AidanJones/pocket_bar_billiards/previews/felt_template_A4.pdf

# Desk bar billiards - felt & marking template

Mini table | ball 9.53 mm | scale 1:5.00

playing area 160.1 x 284.1 mm

PRINT AT 100% / 'Actual size' - check the 50 mm bar on every page.

Pages are numbered row-col; tape them together on the

alignment crosses (2 rows x 1 cols).

Solid outline | = felt cut line (it butts up to the rail cushions).
Hole circles | = cut the felt at 11.4 mm.
Black dot | = black skittle. | White dots = white skittles.

Dashed circles = alternative white position (in front of the 50s).

Red dot = red-ball spot. White dot in the D = starting spot.

Mark the spots through the paper with an awl or a fine pen, then

cut the holes with a sharp craft knife.

x100 x10 x1

| 0 1 2 3 4 5 6 7 8 9

# Scoreboard scale

PRINT AT 100% / 'Actual size' - check the 50 mm bar below.

Cut out the two dashed strips and glue them to score_face:

the digit strip under the bottom row, the multiplier strip

down the left-hand edge. The grey outline is the plate and

the grey bars are the slots - they are there to line it up,

not to cut.

50 mm

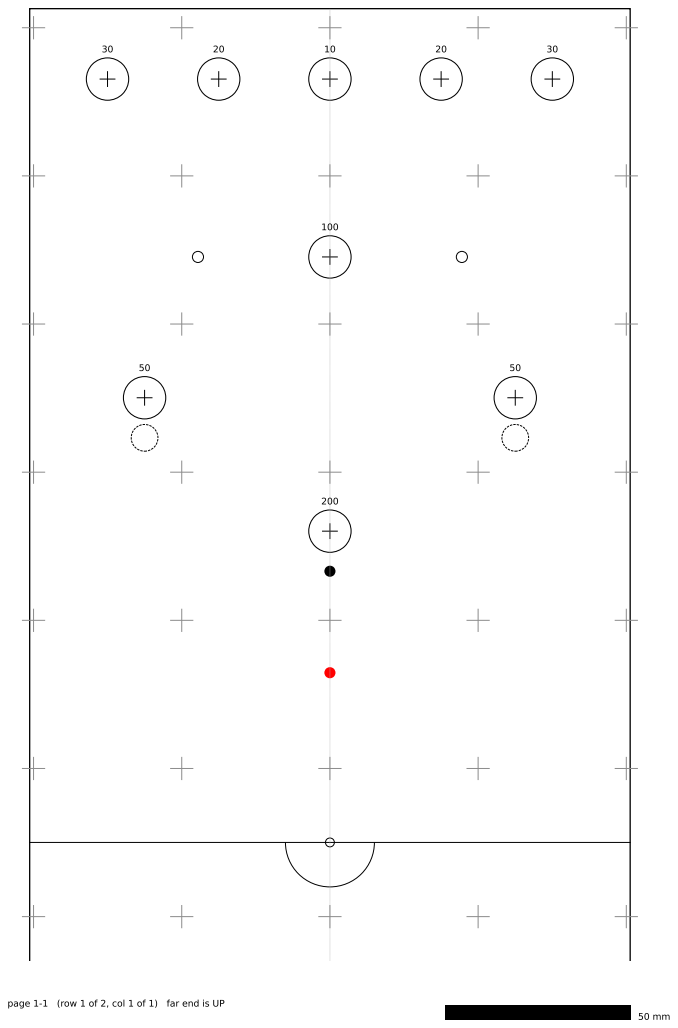
[picture p14: page 3]

page 1-1 (row 1 of 2, col 1 of 1) far end is UP

page 2-1 (row 2 of 2, col 1 of 1) far end is UP 50 mm
