AidanJones/pocket_bar_billiards/stl/score_marker.stl

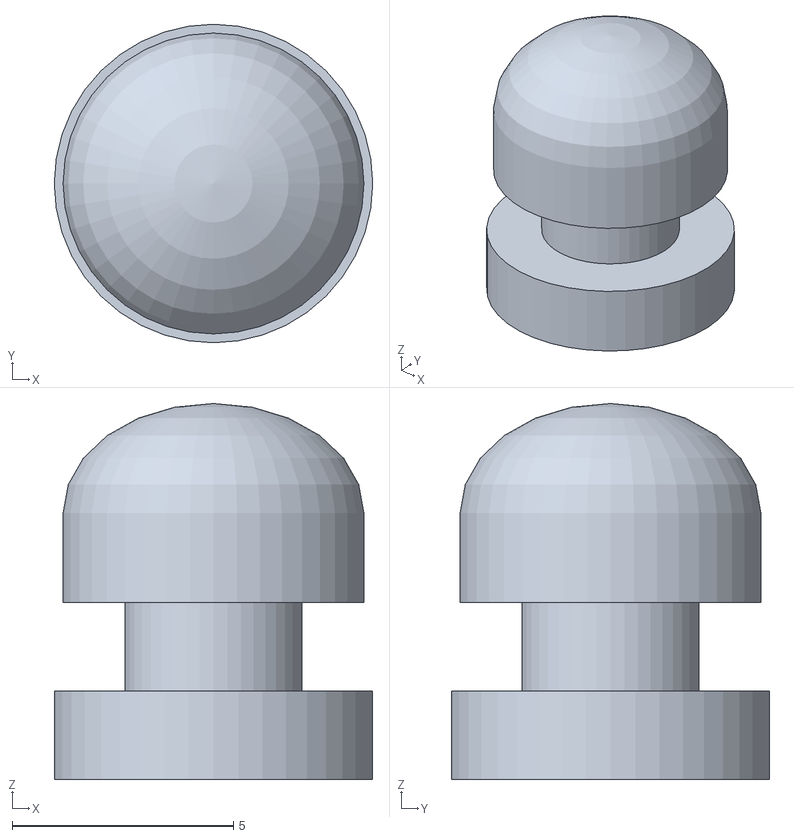
[picture p15: CAD file, 2026-11-01]
stl/score_marker.stl
7.20 x 7.20 x 8.50
