AidanJones/pocket_bar_billiards/stl_coupon/test_ramp.stl

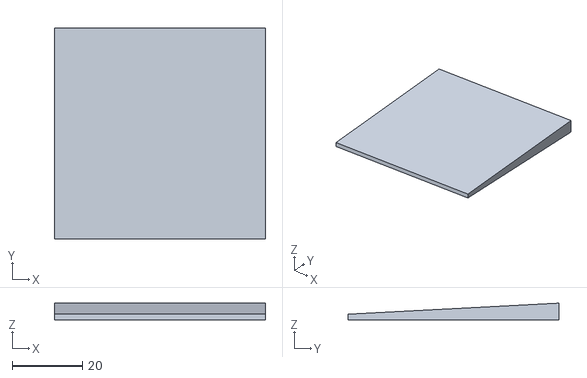
[picture p16: CAD file, 2026-11-01]
stl_coupon/test_ramp.stl
60.0 x 60.0 x 4.76
