AidanJones/pocket_bar_billiards/stl/score_track.stl

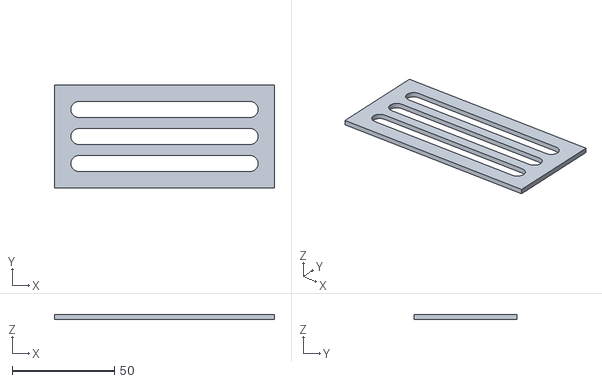
[picture p17: CAD file, 2026-11-01]
stl/score_track.stl
107.5 x 50.2 x 2.40
