AidanJones/pocket_bar_billiards/stl_coupon/test_hole_gauge.stl

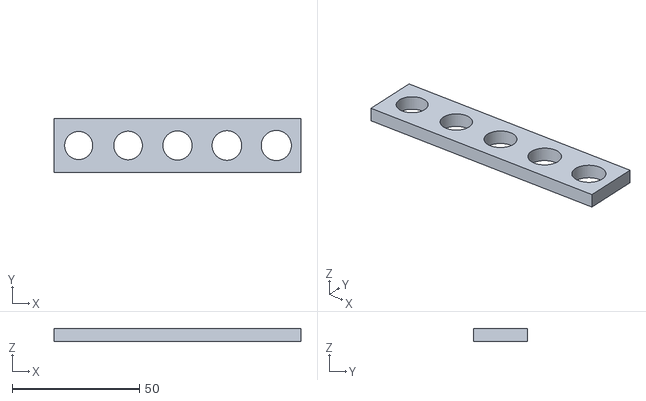
[picture p18: CAD file, 2026-11-01]
stl_coupon/test_hole_gauge.stl
97.2 x 21.4 x 5.00
