AidanJones/pocket_bar_billiards/stl/score_back.stl

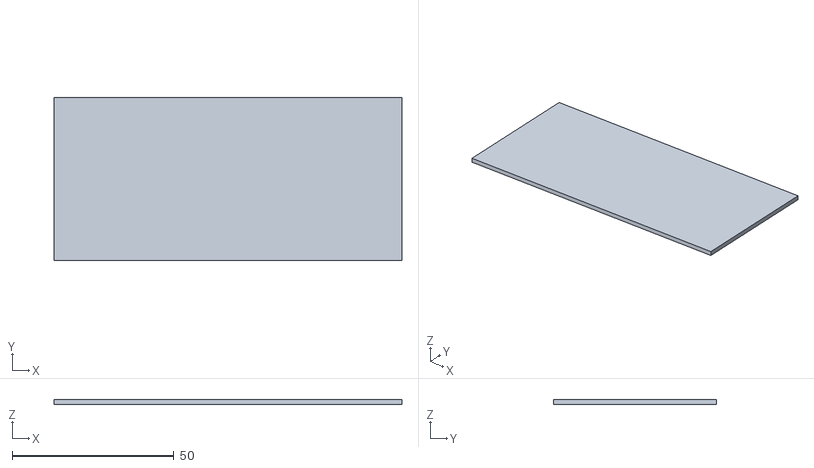
[picture p19: CAD file, 2026-11-01]
stl/score_back.stl
107.5 x 50.2 x 1.60
