AidanJones/pocket_bar_billiards/stl_coupon/test_playfield_corner.stl

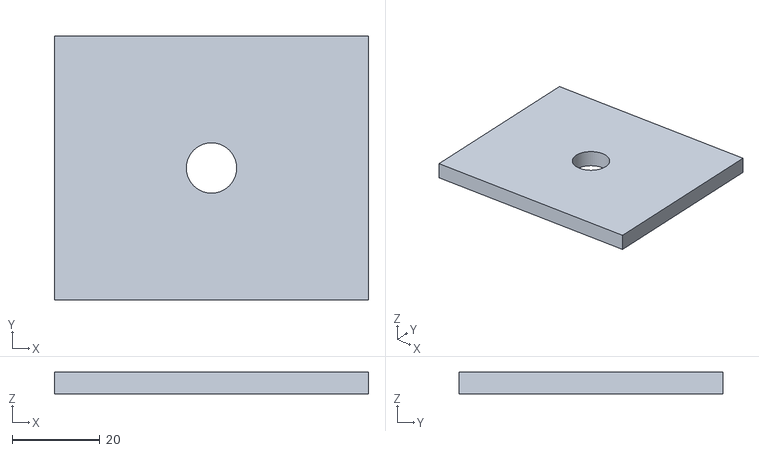
[picture p20: CAD file, 2026-11-01]
stl_coupon/test_playfield_corner.stl
71.4 x 60.0 x 5.00
