AidanJones/pocket_bar_billiards/stl/score_face.stl

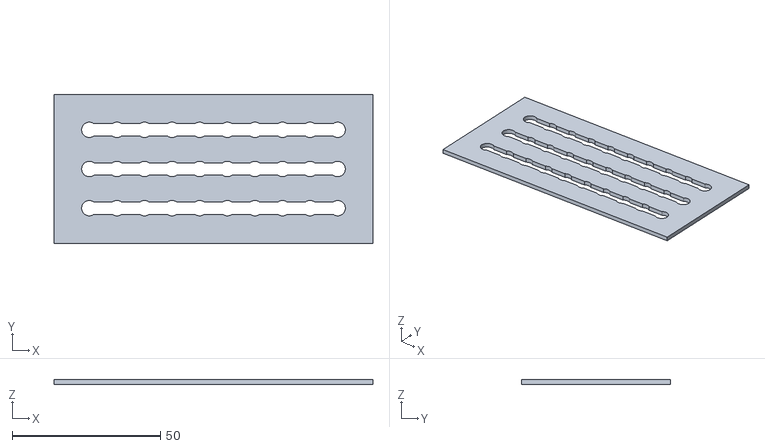
[picture p21: CAD file, 2026-11-01]
stl/score_face.stl
107.5 x 50.2 x 1.60
