AidanJones/pocket_bar_billiards/stl_coupon/test_rail.stl

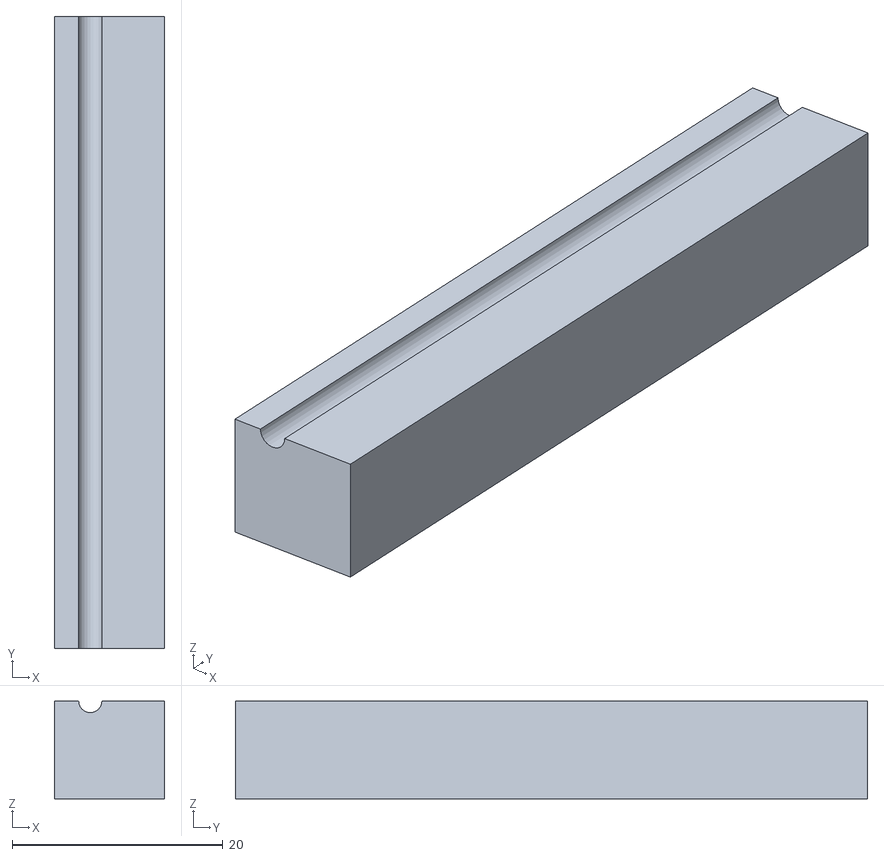
[picture p22: CAD file, 2026-11-01]
stl_coupon/test_rail.stl
10.4 x 60.0 x 9.30
