AidanJones/pocket_bar_billiards/stl/side_wall_left_2.stl

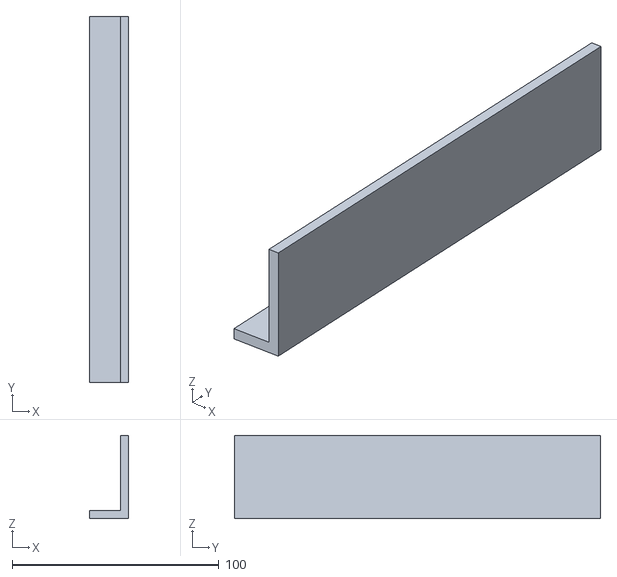
[picture p23: CAD file, 2026-11-01]
stl/side_wall_left_2.stl
19.0 x 177.2 x 40.3
