AidanJones/pocket_bar_billiards/stl_coupon/test_skittle.stl

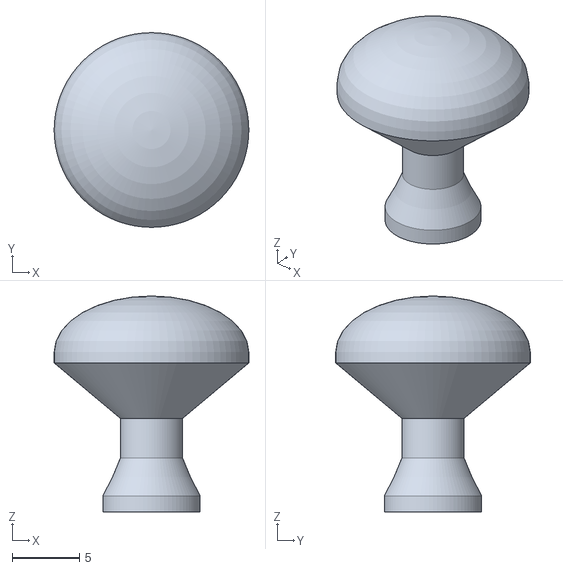
[picture p24: CAD file, 2026-11-01]
stl_coupon/test_skittle.stl
14.4 x 14.4 x 16.0
