AidanJones/pocket_bar_billiards/stl/time_bar_gate.stl

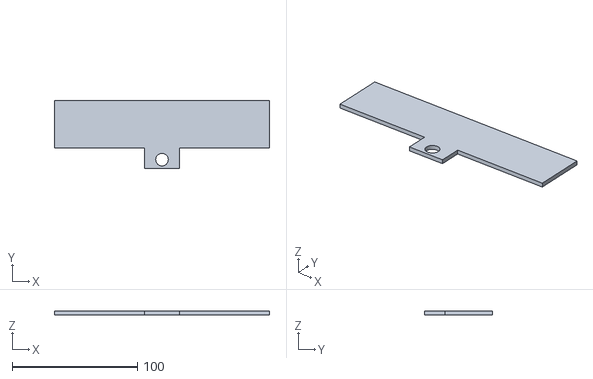
[picture p25: CAD file, 2026-11-01]
stl/time_bar_gate.stl
171.5 x 54.1 x 3.00
