AidanJones/pocket_bar_billiards/stl_coupon/test_clamp.stl

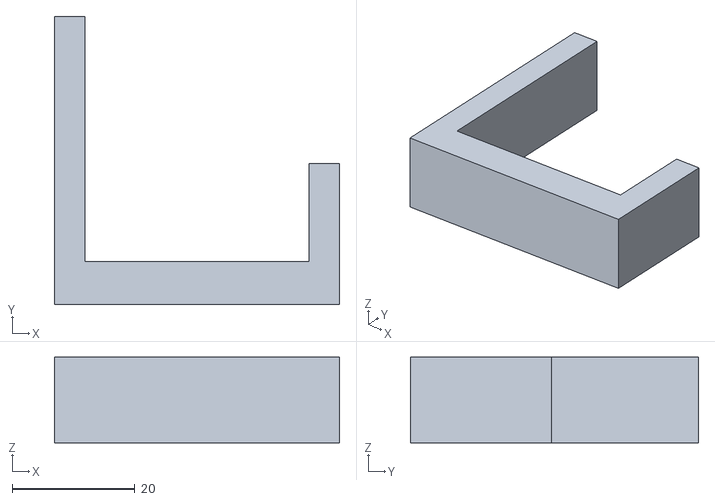
[picture p26: CAD file, 2026-11-01]
stl_coupon/test_clamp.stl
46.5 x 47.0 x 14.0
