AidanJones/pocket_bar_billiards/stl_coupon/test_ledge.stl

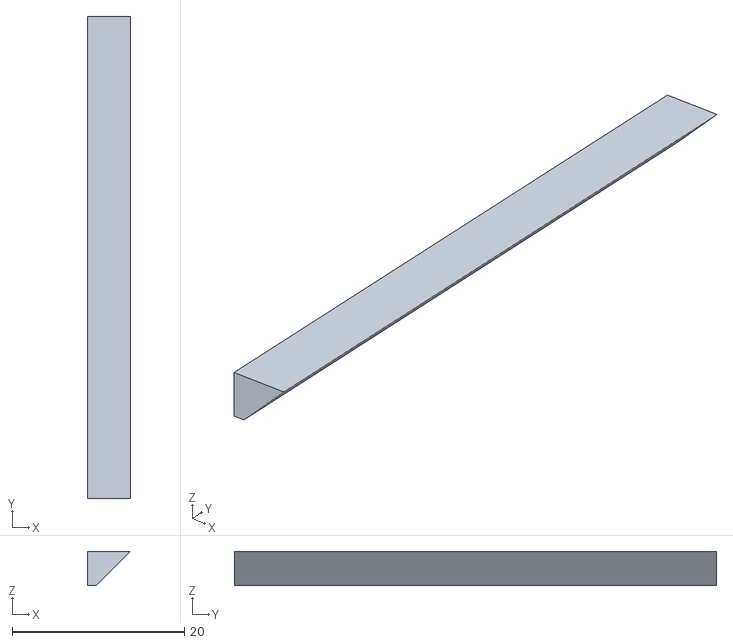
[picture p27: CAD file, 2026-11-01]
stl_coupon/test_ledge.stl
5.00 x 56.0 x 4.00
