AidanJones/pocket_bar_billiards/stl/cue_butt.stl

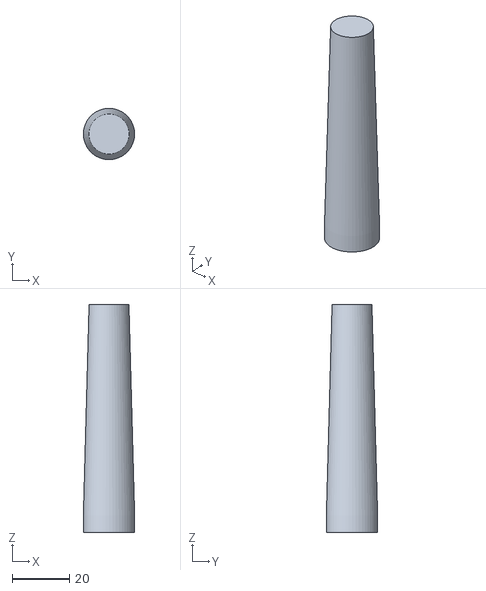
[picture p28: CAD file, 2026-11-01]
stl/cue_butt.stl
18.0 x 18.0 x 80.0
