AidanJones/pocket_bar_billiards/stl_coupon/test_wall.stl

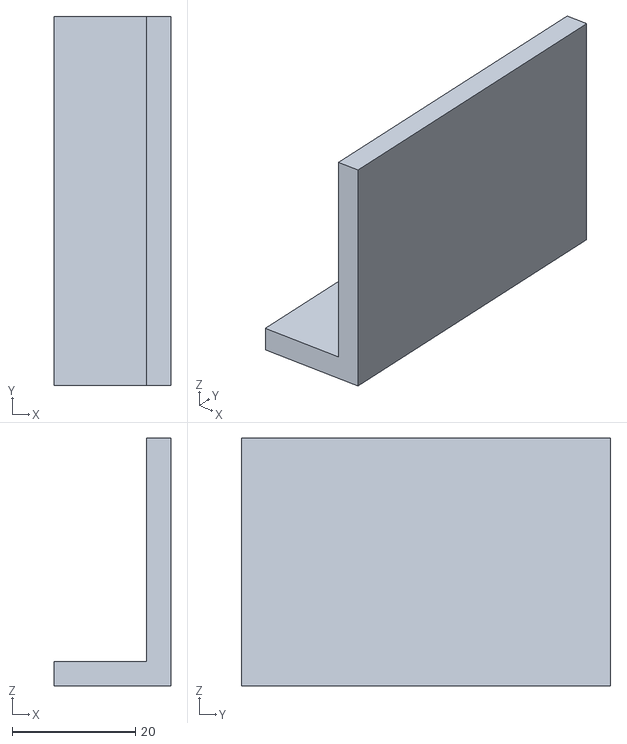
[picture p29: CAD file, 2026-11-01]
stl_coupon/test_wall.stl
19.0 x 60.0 x 40.3
