AidanJones/pocket_bar_billiards/stl/back_wall.stl

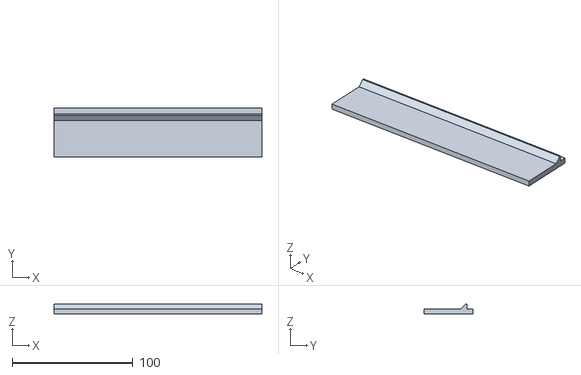
[picture p31: CAD file, 2026-11-01]
stl/back_wall.stl
172.3 x 40.3 x 8.00
