AidanJones/pocket_bar_billiards/stl/rail_side_left_1.stl

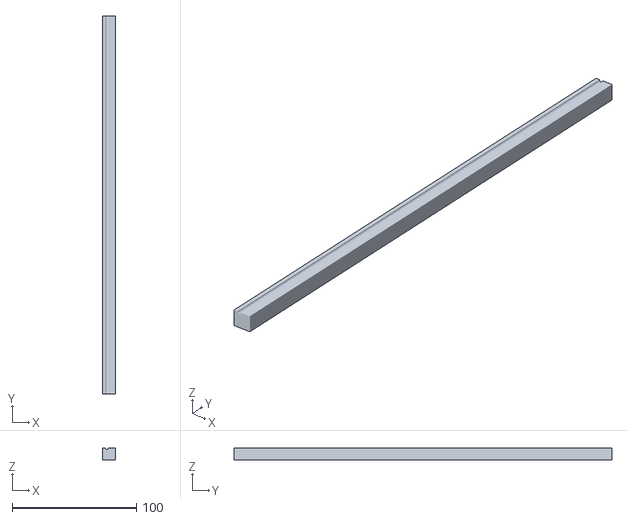
[picture p32: CAD file, 2026-11-01]
stl/rail_side_left_1.stl
10.4 x 304.8 x 9.30
