AidanJones/pocket_bar_billiards/stl/tray_lip.stl

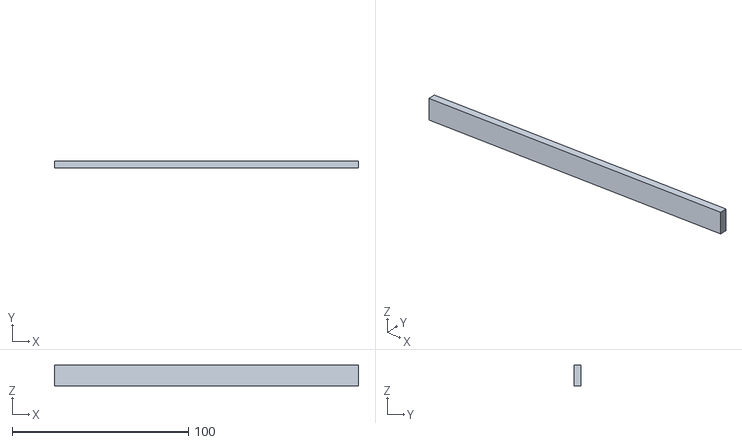
[picture p33: CAD file, 2026-11-01]
stl/tray_lip.stl
172.3 x 4.00 x 11.6
