AidanJones/pocket_bar_billiards/stl/clamp_shim.stl

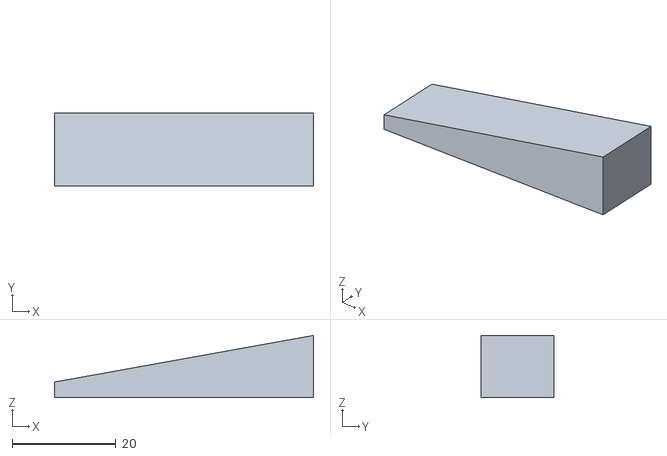
[picture p34: CAD file, 2026-11-01]
stl/clamp_shim.stl
50.0 x 14.0 x 12.0
