AidanJones/pocket_bar_billiards/stl/apron_beam.stl

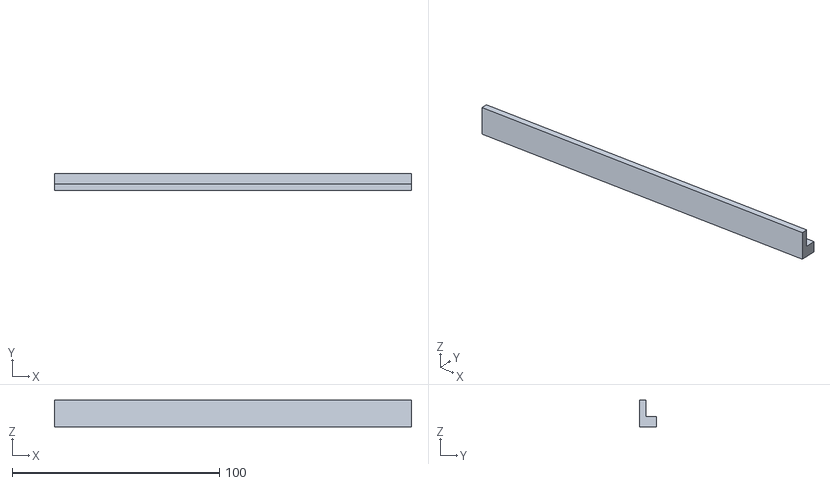
[picture p35: CAD file, 2026-11-01]
stl/apron_beam.stl
172.3 x 8.00 x 13.0
