AidanJones/pocket_bar_billiards/stl/ledge_strip_right_1.stl

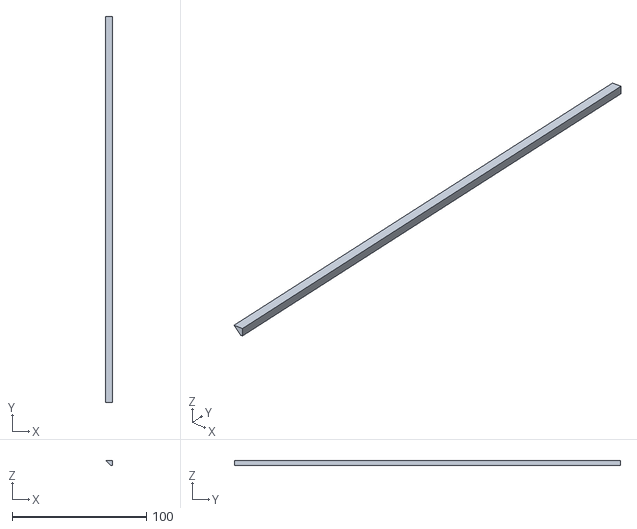
[picture p36: CAD file, 2026-11-01]
stl/ledge_strip_right_1.stl
5.00 x 287.2 x 4.00
