AidanJones/pocket_bar_billiards/stl/rail_far.stl

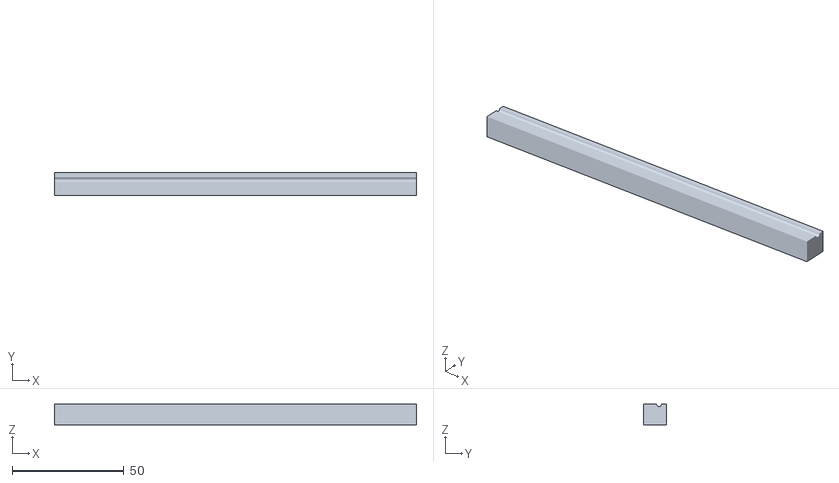
[picture p37: CAD file, 2026-11-01]
stl/rail_far.stl
162.1 x 10.4 x 9.30
