AidanJones/pocket_bar_billiards/stl/cue_tip_ferrule.stl

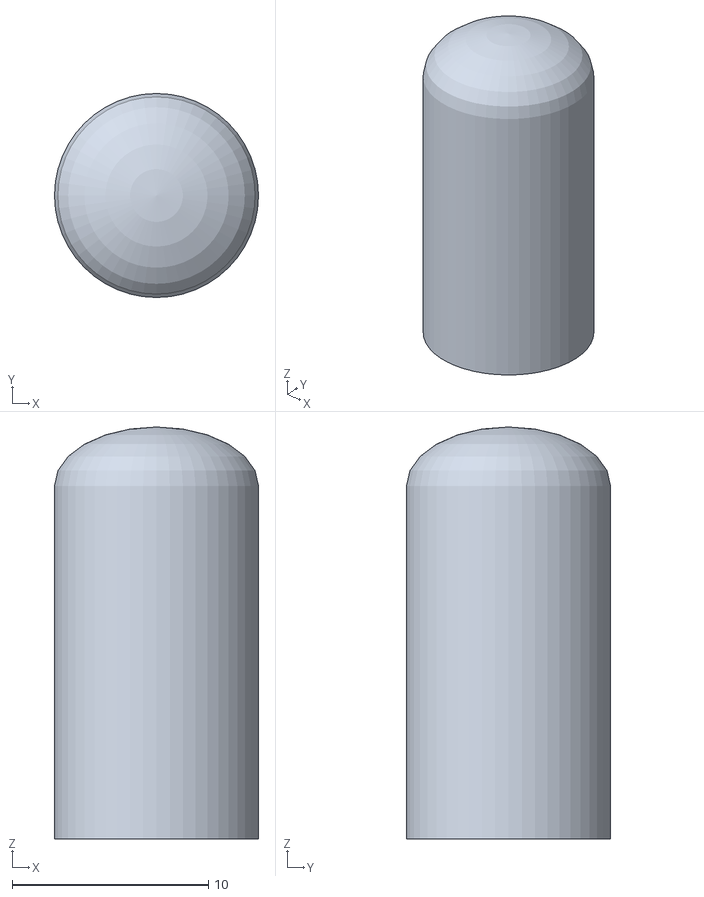
[picture p38: CAD file, 2026-11-01]
stl/cue_tip_ferrule.stl
10.4 x 10.4 x 21.0
