AidanJones/pocket_bar_billiards/stl/playfield_r1_c1.stl

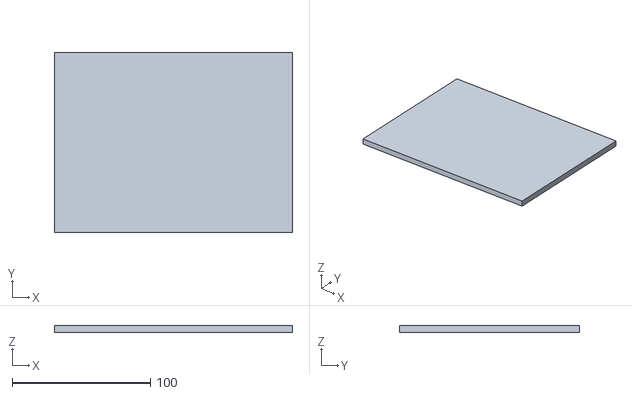
[picture p39: CAD file, 2026-11-01]
stl/playfield_r1_c1.stl
172.1 x 130.1 x 5.00
