AidanJones/pocket_bar_billiards/stl/front_beam.stl

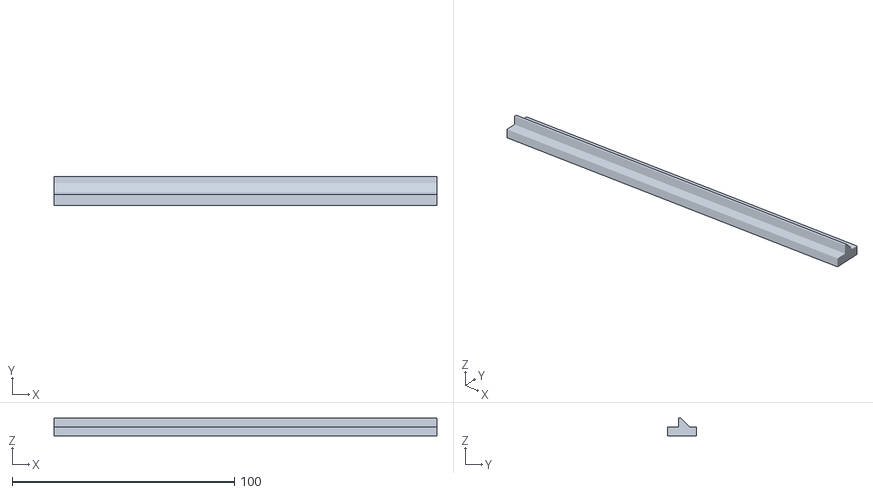
[picture p40: CAD file, 2026-11-01]
stl/front_beam.stl
172.3 x 13.0 x 8.00
