AidanJones/pocket_bar_billiards/stl/ramp_r2_c1.stl

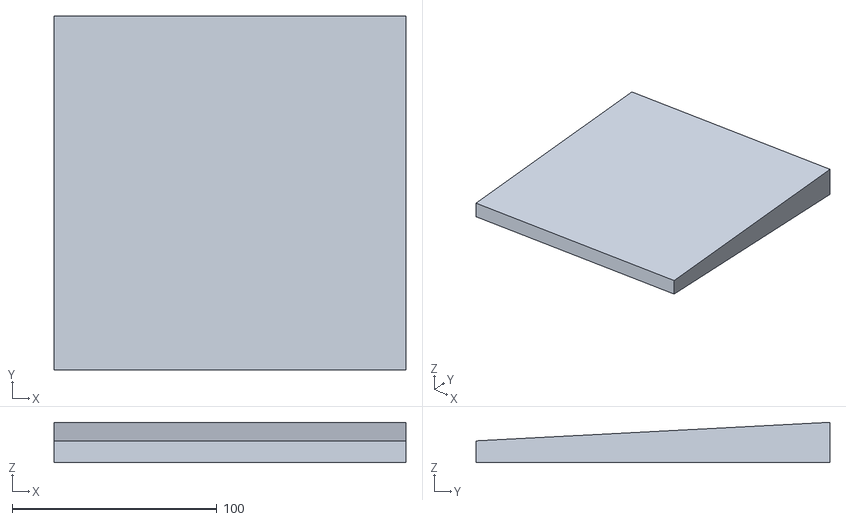
[picture p41: CAD file, 2026-11-01]
stl/ramp_r2_c1.stl
171.7 x 172.9 x 19.7
