AidanJones/pocket_bar_billiards/stl/splice_cross_1.stl

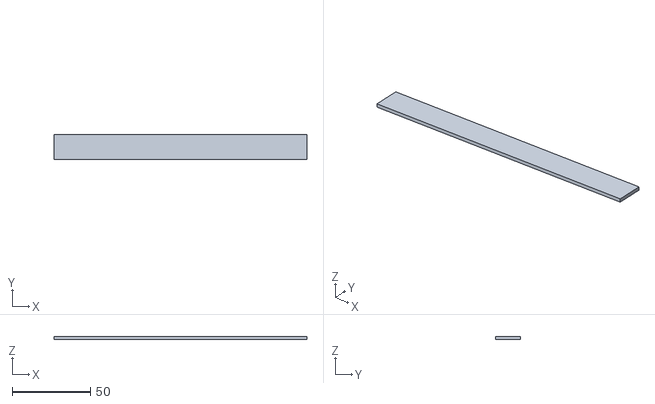
[picture p42: CAD file, 2026-11-01]
stl/splice_cross_1.stl
162.1 x 16.0 x 2.00
