AidanJones/pocket_bar_billiards/stl/playfield_r2_c1.stl

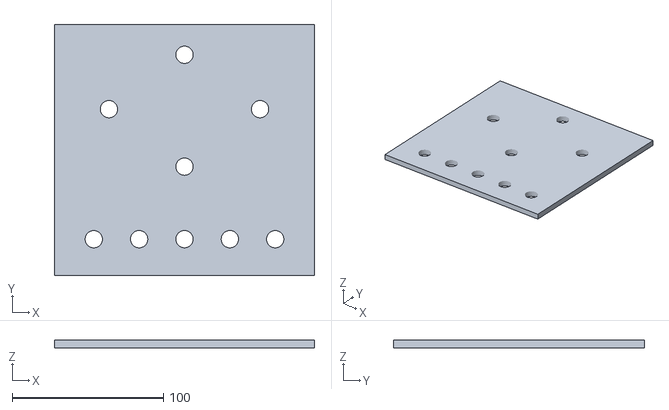
[picture p43: CAD file, 2026-11-01]
stl/playfield_r2_c1.stl
172.1 x 166.1 x 5.00
