AidanJones/pocket_bar_billiards/(list of files, cad)

Other CAD files:
stl/skittle.stl
stl/desk_clamp_25mm.stl
stl/side_wall_left_1.stl
stl/side_wall_right_2.stl
stl/rail_side_right_1.stl
stl/ledge_strip_left_1.stl
stl/rail_front.stl
stl/side_wall_right_1.stl
