AidanJones/pocket_bar_billiards/(commit log)

2026-11-01 Parametric desk bar billiards generator
    A scale English bar billiards table that clamps to a desk edge and prints
    in pieces. Sizes itself from the ball you buy and the printer you own.
    Structure:
    profiles.py printers, filaments and table sizes, as data
    meshlib.py numpy mesh kernel: prism(), lathe(), STL writer
    components.py reusable printable components; no table knowledge
    table.py the design, composed from components; no file I/O
    barbilliards.py CLI: build, validate, export, pack plates
    check.py design rules; --all sweeps every printer and size
    render.py previews, layout plan, 1:1 A4 felt template
    Defaults are a Bambu Lab P1S, PLA, the Mini siz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
    [apron_beam.stl, back_wall.stl, clamp_shim.stl, cue_butt.stl, cue_tip_ferrule.stl, desk_clamp_25mm.stl, front_beam.stl, ledge_strip_left_1.stl]
2026-11-01 Add a slider scoreboard and an optional score-sorted ball return
    Scoreboard (always built): three rows of 0-9 for hundreds, tens and units,
    as three flat plates glued into a sandwich with the markers already inside,
    so they cannot come out. The top plate's slots have a round bay at each
    position, so a marker settles on a digit instead of anywhere. No snap fit --
    nothing printed flat like that would spring -- so it is a friction fit with
    0.15 mm of play. A 1:1 paper scale goes in the template PDF.
    Sorted return (--return sorted, off by default): nine lanes under the bed,
    one per hole, so a returned ball sits in a compartment that says what it
    scored. return_lanes() solves the boundaries from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
    [parts.csv, score_back.stl, score_face.stl, score_marker.stl, score_track.stl]
2026-11-01 Add a glTF export and a Godot game from the same model
    table.py stays the one model. barbilliards.py slices it into printable
    pieces; gltf.py now writes the assembled thing as a single .glb plus the
    JSON the game needs for holes, spots and lane extents. Nothing is modelled
    twice, and no Blender step: the geometry is generated, the parts are
    flat-coloured, and the whole table is ~8,700 triangles, which is nothing
    for a browser or a headset.
    The game runs life size -- a real league table, 47.6 mm ball -- because
    Godot's solver is happiest around human scale and because in VR you want to
    stand at a real table. Same generator, different --ball; --as-printed
    simulates what you are actually going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
    [export_presets.cfg]
2026-11-01 Run the game, and fix the bug it found
    The Godot side now actually executes. Three GDScript type errors, then the
    physics test had something to say.
    Generator bug: place() mirrors a profile about its origin, and the left-hand
    side walls, ledges and rails were mirrored but left at the right-hand
    origin. Both side walls sat on the +X side and the left of the table was
    open. The printed parts were unaffected -- each STL is centred on the plate
    and the shape was right -- so it passed every geometry rule, fit the bed and
    rendered plausibly. It showed up as balls leaving the table sideways.
    check.py now requires every _left part to be the mirror image, in place, of
    its _right twin, and the assemb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
2026-11-01 Fix the sorted return's chutes: 5 of 9 -> 9 of 9
    The simulation said the four chuted holes all failed. Three things were
    wrong, none of them visible in the geometry.
    Too shallow. The chute had a fixed 4.4 mm rise spread over up to 59 mm --
    4 to 8 degrees -- and a ball dropped onto that just sits on it. It now
    takes all the rise the headroom under the bed allows and spans no further
    than the ball actually has to move, giving 12 to 18 degrees.
    It finished against the lane wall, 0.5 mm clear of it, so a ball that did
    roll down wedged between chute and wall. That was the resting height the
    test kept reporting. It now stops at the *near* wall of the lane it
    delivers to: a lane is only about a b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
2026-11-01 Add TODO.md, and make the setup docs work on any machine
    Moving the work to another box, so: a list of what is actually done, what
    is unverified and what to do next, and setup instructions that are not
    Windows-only.
    TODO.md leads with the state of play -- the generator covers 84 printer x
    size x variant x return combinations, both ball returns simulate 9 of 9,
    and nothing whatsoever has been printed. Then, in order of what would
    teach us most: print the coupon and feed the hole gauge back; run the web
    export and VR, neither of which has ever been executed; the generator's
    open ends; and what a faster machine buys, with timings from this one
    (check.py --all 96 s, render.py 21 s, physics_test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
2026-11-01 Make the Godot game playable: rules, skittles, cue, HUD; fix Docker on SELinux
    - rules.gd: breaks, red doubles, white/black skittle penalties, opening
    shot must hit the red; game.gd runs the shot cycle around it, playing
    each ball from the tray in the D, with a timer that drops the bar.
    - Skittles are now dynamic bodies, collision read off the lathe mesh, and
    seated on the real bed (the felt is not in the mesh).
    - Pocket sensors sit under the bed: the old ones scored balls that only
    rolled past a hole.
    - Damping and bounce apply only on the felt, so the tested return is
    untouched (physics_test still 9 of 9, shared and sorted).
    - Cue: drawn-back stick, power bar, ghost-ball aim guid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
    [export_presets.cfg]
2026-11-01 Ship a working web build, a browser end-to-end test and a shot guide
    - Web export now actually works: the .glb is marked importer="keep" so
    it is packed as-is (an imported resource's source is dropped from the
    pck whatever include_filter says), mobile VRAM compression is off (it
    was a silent configuration error), and the output path is mounted.
    - godot/e2e/web_smoke.py: headless Chromium in the Playwright image loads
    the export, clicks Play, drags a shot with the mouse and checks it was
    scored, with no page errors. Passes.
    - Aim guide: object ball along the line of centres, cue ball along the
    tangent, cushion rebound; drawn as ribbons. Power bar shades green to red.
    - Skittles: 1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
    [export_presets.cfg]
2026-11-02 Game: computer opponent, up to 4 players, score limit, every rule tested
    What the owner asked for after the first play: the turn passes on no score,
    a computer player for one-player games, the rules readable in the game,
    tests for every rule, two to four players, a score limit, a way to reset,
    hole values on the felt, a little help into the pockets, and a rule for a
    ball knocked off the table.
    Rules (rules.gd, checked against the league rules): fouls now lose the
    break (no ball hit, ball off the table, white skittle, opening shot missing
    the red or clearing the table); the red is re-spotted and must be hit
    whenever the table is cleared; with every ball in play the one nearest the
    D is playe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
    [export_presets.cfg]
2026-11-02 Game: play the red from the tray with E or a button; say it is not re-spotted
2026-11-02 Game: always start with a white in the D
    In the browser the first ball was moved twice in one frame (into the tray by
    the re-rack, then into the D) and the physics put it back in the tray, so the
    first shot was played from there and fouled. Let the re-rack settle first,
    keep the shot cycle idle meanwhile, put a ball in hand back if it is ever
    found off the table, and do not wait on frozen balls.
2026-11-02 Game: a click is never a shot; power is the pull back from the press
    Pressing away from the ball (just after clicking the spin pad or the red
    button, say) put the cue's butt there, so the press was already a hard pull
    and letting go fired it. Power now counts only the pull back since the
    press; easing back or a right-click calls a shot off. The browser test
    clicks the felt and checks no shot follows (it fails on the old cue).
2026-11-02 Woodworking plans: the same table built in wood
    woodwork.py reads the one model (table.Dims and design()) for everything a
    ball touches - playing area, holes, cushion height, headroom, return slope,
    tray and gate - and changes only the construction: stocked sheet
    thicknesses, the nearest real Forstner bit or hole saw, a hardboard ramp on
    tapered bearers, hardwood rails with a cord groove. It writes wood/cut_list.csv,
    wood/wood_plan.md (buy list, tools, cut list, marking out, steps, checks) and
    previews/wood_plan.png (bed plan with hole centres, section, and the player's
    end drawn larger). Any --size or --ball works, up to a full league table.
    check.py runs the wooden build's rules (bit size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
    [cut_list.csv]
2026-11-02 Wooden build: rebated and housed frame, mitred rails
    The back wall and tray lip sit in rebates in the side walls; the apron and
    front beam share one housing, with a filler ripped to the slot width between
    them (two housings would leave a sliver of ply a few mm wide). Cross pieces
    are lengthened into the joints, the rails meet in 45 degree mitres, and the
    guide gets a joint table, the tools and the glue-up. The drawing adds the
    side wall's inside face with the cuts and shows the mitred rail frame.
    --joints butt keeps the plain version. check.py applies the wood rules to
    both, plus: housings half the wall deep, a wall's thickness between them,
    the filler sets the slot clear of the gate. check.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
    [cut_list.csv]
2026-11-03 README: build and run the browser game, including on Windows
    Step-by-step for Docker Desktop and PowerShell, how to stop and rebuild,
    serving an existing build, and why file:// does not work. .gitattributes
    keeps shell scripts LF so a Windows checkout still builds the VNC image.
